FrostyTramy/RoboPacerV2/(commit log)

2026-08-01 Initial commit: RoboPacerV2
    RC car pacing project - Raspberry Pi 5 + Hailo-8 AI Kit.
    - data_recorder/: behavioral-cloning data capture (camera + Xbox controller)
    - camera/: standalone camera recorder
    - main/: autonomous drive - runs a .hef model on the Hailo, D-pad throttle control
    - trainer/: Windows-side training + Hailo HEF compile (Flask UI + Docker)
    - safety/: ESC fail-safe watchdog (systemd service)
    - tools/: servo and camera calibration utilities
    [camera_calibrate.py, data_recorder.py, main.py, servo_calibrate.py]
2026-08-01 Fix train/inference preprocessing docs, dataset loading robustness, trainer folder-or-json input
    - main.py: correct stale docstring (trainer now uses cv2, not PIL) and
    cross-reference train.py's preprocessing explicitly
    - trainer/train.py: SteeringDataset raises a clear error on an unreadable
    image instead of crashing on None; accept a dataset folder path (not
    just the driving_log.json file) and auto-append driving_log.json
    - trainer/index.html, README.md: reflect the folder-or-json input
    [main.py]
2026-08-01 Fail fast on missing Docker/DFC wheel, add compile-only recovery path
    The HEF compile step could fail after a multi-hour training run over a
    problem (Docker not running, DFC wheel not in place) that was entirely
    knowable before training started. Also fixed a bug where the .onnx
    export was deleted even when the compile step failed, making recovery
    impossible without retraining.
    - check_compile_prereqs(): checks Docker + the DFC wheel exist before
    training starts, not after
    - run(): only deletes .onnx/.har intermediates on a successful compile
    - retry_compile() + /api/compile + "Retry compile" button: recompiles
    from an existing .pth/.onnx without retraining; re-exports ONNX from
    the ch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
2026-08-01 Add 0-epoch pipeline smoke test, namespace calibration data per model
    - run_smoke_test() / "Test export (0 epochs)" button: builds an
    untrained model and runs it through the full ONNX export + Docker +
    Hailo DFC compile pipeline in seconds, so setup problems (wheel
    missing, Docker down, DFC bugs) surface before a multi-hour training
    run instead of after. Writes to models/smoketest.* only.
    - Fixed a real bug this introduced risk of: calib_data_nhwc.npy was a
    single shared file across all models/runs, so the smoke test (or any
    retry_compile of an older model) could silently overwrite a different
    model's calibration data. Now namespaced as <model_name>_calib_data_nhwc.npy
    in tra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
2026-08-01 Prevent CRLF-corrupted compile.sh, verify compile actually produced a .hef
    The smoke test caught a real bug: compile.sh got CRLF line endings on a
    Windows checkout (likely core.autocrlf), which breaks bash inside the
    Linux container in a way that's easy to miss - set -e itself gets
    mangled, so every subsequent hailo command fails but the script keeps
    going anyway and still prints "SUCCESS" at the end with exit code 0.
    - .gitattributes: force LF for *.sh/*.py/*.md/Dockerfile regardless of
    the checkout platform, CRLF for *.bat (native on Windows)
    - compile_hef(): stop trusting the script's exit code alone - verify
    models/<name>.hef actually exists on disk before reporting success
2026-08-01 Add ESC + controller drive test to servo_calibrate.py
    Static "wheels look straight" isn't the same as "goes straight while
    moving" - torque steer, alignment, and suspension slop only show up in
    motion. Now arms the ESC (if an Xbox controller is found) and reads
    gas/brake triggers the same way data_recorder.py does, so you can drive
    forward while live-adjusting the steering center trim with the keyboard.
    Falls back to servo-only calibration if no controller is connected.
    Rewrote the keyboard reader as non-blocking (select-based) so it can
    share the main loop with controller polling - the old version blocked
    on a single keypress, which doesn't work once there's a second input
    source to also w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
    [servo_calibrate.py]
2026-08-01 Add joystick steering to servo_calibrate.py
    Xbox left stick X now steers the servo, deflecting around whatever the
    keyboard-set trim pulse currently is - same deadzone shape as
    data_recorder.py's steering_axis_to_angle, just in raw microseconds
    around a live-adjustable center instead of a fixed angle. Lets you
    actually drive and steer normally while dialing in the center trim,
    instead of only being able to nudge a static pulse with the keyboard.
    [servo_calibrate.py]
2026-08-01 Add A-button TEST mode to servo_calibrate.py
    Press A to lock in the current min/center/max marks and drive steering
    through the exact angle math data_recorder.py/main.py use (deadzone,
    SERVO_OFFSET derived from the marks, angle->pulse via the calibrated
    min/max) instead of the generic symmetric trim range used while still
    adjusting. Press A again to go back to SET mode. Keyboard calibration
    keys are ignored while in TEST mode to avoid confusing live-adjustment
    with the committed snapshot being tested.
    [servo_calibrate.py]
2026-08-01 Make SET/TEST modes mutually exclusive in servo_calibrate.py
    SET mode: only the keyboard touches the servo, stick is fully ignored
    (not just deadzone - no effect at all). TEST mode: only the stick
    touches the servo, keyboard calibration keys do nothing. Previously the
    stick could also nudge the servo during SET mode, which wasn't the
    intent - SET should be keyboard-only until you explicitly switch to
    TEST with A. Removed the now-unused generic-trim-range steering
    function.
2026-08-01 Make TEST mode use exact marked min/center/max, not the safety-clamped angle range
    The previous TEST mode routed the stick through the same 45-135deg
    angle math the real system uses, which never reaches SERVO_MIN_PULSE/
    SERVO_MAX_PULSE exactly (that range is a deliberate safety margin below
    the physical endpoints) and introduced integer-degree rounding error at
    center. Replaced with a direct 3-point piecewise-linear mapping in
    pulse space: stick centered -> exactly the marked CENTER, full
    deflection either way -> exactly the marked MIN/MAX. This is for
    testing the calibration points themselves (does full lock-to-lock feel
    right), not for replicating production's clamped throw.
    [servo_calibrate.py]
2026-08-01 Add temporary debug logging for controller button events in servo_calibrate.py
    Investigating a report of TEST mode activating without pressing A and
    before all 3 marks are set - the guard logic requires both, so this
    prints every button press's raw evdev code to find out what's actually
    firing (possibly a different physical button reporting as BTN_A on this
    controller).
2026-08-01 Fix arrow keys getting silently dropped in servo_calibrate.py
    The escape-sequence continuation (ESC + 2 bytes for arrow keys) only
    waited 10ms and used a single read(2) call, which can short-read if the
    second byte hasn't arrived yet. Over SSH that's often not enough - the
    symptom was `pulse` staying frozen regardless of arrow presses.
    Read the 2 bytes one at a time with a 100ms timeout each instead.
    (Confirmed from a pasted session: every status line showed the exact
    same pulse=1500us, and min/max both got marked at that same default
    value - consistent with arrow presses never registering. The reported
    "auto-enters TEST mode" symptom didn't show up in that same session -
    no [debug] button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
    [servo_calibrate.py]
2026-08-01 Add raw keyboard byte debug logging to servo_calibrate.py
    Two reported sessions both show pulse/marks freezing entirely partway
    through - not just arrow keys, all keyboard input stops registering,
    including plain letters like 'c'. Logging every raw byte read from
    stdin and what key it resolved to, to find out whether bytes stop
    arriving entirely or arrive but get misparsed.
    [servo_calibrate.py]
2026-08-01 Remove debug logging from servo_calibrate.py
    Was just noise - false alarm turned out to be the debug prints
    themselves making it look like TEST mode had activated. Arrow-key fix
    and mutually-exclusive SET/TEST modes both confirmed working correctly.
    [servo_calibrate.py]
2026-08-01 Update servo calibration: min=900us, center=1580us, max=2200us
    SERVO_OFFSET recomputed from these marks: round((1580-900)/(2200-900)*180-90) = 4.
    Applied identically to data_recorder.py and main.py.
2026-08-01 Fix ESC arm pulse: use neutral, not full reverse/brake
    Root cause of the car occasionally launching into full-speed reverse
    right after (re)starting a script, confirmed against the QuicRun
    10BL120 manual: this ESC has no concept of a special "arm at an
    extreme pulse" signal - it just needs a stable, valid signal, and any
    pulse it receives is a real command it will act on. ESC_ARM_PULSE_US
    was set to 1000us (ESC_MIN_US, full reverse/brake), held for 3 seconds
    at every startup.
    In "Forward/Reverse with Brake" mode (this ESC's configured setting),
    holding brake/reverse position is only supposed to brake on the first
    push - reverse requires returning to neutral and pushing again. But
    depending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
    [data_recorder.py, main.py, servo_calibrate.py]
2026-08-02 Add steering deadzone/faster smoothing and frame-stacked temporal input
    - main.py: raise SMOOTH_ALPHA (less lag) and add STEERING_DEADZONE to cut
    the high-speed oscillation and straight-line weaving reported on track.
    - Add frame stacking (temporal memory): model now sees the current frame
    plus 2 history frames spaced ~100ms/~200ms apart in wall-clock time
    (not fixed frame-count stride, since consecutive captures at ~100fps
    are too close together to carry any motion signal). Implemented in
    train.py (dataset assembly, widened conv1 with tiled pretrained
    weights, calibration data) and main.py (live rolling buffer), with
    session-boundary-aware padding on both sides. Requires re-re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
    [data_recorder.py, main.py]
2026-08-02 Split train/val by time blocks, not individual frames
    Random per-frame shuffling let near-duplicate frames (a few ms apart at
    high recording fps) land on opposite sides of the split, letting val loss
    partly grade the model on frames it had effectively already trained on.
    Now shuffles and splits whole ~3s time blocks (cut at session boundaries)
    instead, so val actually measures generalization.
2026-08-02 Move frame writes off the control loop to fix multi-second freezes
    cv2.imwrite ran inline in the same loop that reads the controller and
    writes servo/ESC pulses. An SD card stall under sustained write load
    (garbage collection/wear-leveling) would block that single call for
    several seconds - freezing the entire loop with it, since nothing else
    runs until it returns. The PCA9685 holds its last duty cycle in hardware,
    so the car kept driving at whatever throttle/steering it had going into
    the stall, unresponsive to any input, looking like a stuck ESC/servo when
    it was actually just a frozen control loop. esc_watchdog didn't catch it
    either since the process was hung, not dead.
    Frame writes now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
    [data_recorder.py]
2026-08-02 Add --raw-steering flag to bypass smoothing/deadzone for testing
    Sends the model's unmodified per-frame prediction straight to the servo,
    so the model's actual raw output can be inspected separately from the
    EMA smoothing and deadzone tuning added on top of it.
2026-08-03 Add classic/timestamped recording formats and weighted steering sampling
    data_recorder.py gets a --legacy flag for classic (image + steering only)
    recording, alongside the default timestamped format needed for frame-stacked
    temporal input. train.py auto-detects which format a dataset is in and trains
    single-frame vs frame-stacked accordingly (model channels, export, calibration
    all follow); main.py auto-detects the same thing at inference time from the
    compiled HEF's own input shape, so nothing needs to be kept in sync manually.
    Also adds a WeightedRandomSampler over steering-magnitude buckets on the
    training split, since real driving logs are dominated by near-zero steering
    (74% exactly 0.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
2026-08-07 Add ESTOP/heartbeat safety daemon, controller rumble feedback, I2C fault tolerance
    - New safety/estop_listener.py + systemd service: reads !!ESTOP!! from an
    ESP32 over USB serial and kills running RoboPacerV2 processes (SIGTERM then
    SIGKILL), while also sending a !!HB!! heartbeat every 500ms so the ESP32's
    own watchdog can cut power if the Pi hangs or the link drops.
    - data_recorder.py: headless by default (--display to show the cv2 window),
    controller rumble on pause/resume/shutdown, servo+ESC stay responsive to
    the joystick while paused, tolerate transient I2C errors (121/19) instead
    of crashing, and don't fail cleanup if pca.deinit() hits a dead bus.
    - main.py: same I2C fault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
    [data_recorder.py, estop_listener.py, main.py]
2026-08-07 Add ESP32 firmware, estop listener and update gitignore
    - Esp32/garmin_receiver/garmin_receiver.ino: BLE GATT server with relay
    control, shared-secret auth, and serial watchdog (cuts relay if RPi
    heartbeat stops for 2s)
    - safety/estop_listener.py: RPi service that sends !!HB!! heartbeat to
    ESP32 and kills driving processes on !!ESTOP!! signal
    - .gitignore: exclude ConnectIQ app, frame sets, Pista-biciclete
2026-08-07 Move ESP32 BLE auth secret out of tracked source
    APP_SECRET was hardcoded in garmin_receiver.ino, which is on GitHub — move it
    to secrets.h (gitignored, lives next to the .ino, picked up automatically by
    Arduino IDE at compile time) and add secrets.h.example as the tracked
    template. The RPi side doesn't need this key at all; it's only shared
    between the Garmin watch app and the ESP32.
    [garmin_receiver.ino]
2026-08-07 Relay auto-on/off from RPi scripts and Garmin live status display
    ESP32:
    - Add STATUS_CHAR (READ) that holds relay state (0x00/0x01) for Garmin polling
    - Parse !!ON!! / !!OFF!! from serial to let RPi scripts control relay
    - Refactor relay writes into updateRelayState() so status char stays in sync
    RPi:
    - estop_listener: add Unix socket (/tmp/esp32_relay.sock) + relay queue;
    main serial loop drains queue and forwards ON/OFF to ESP32
    - main.py / data_recorder.py: send RELAY_ON on start, RELAY_OFF in finally
    Garmin:
    - RunningView: full green (ON) / red (OFF) background with large ON/OFF text
    - RunningDelegate: 1s timer polls STATUS_CHAR via requestRelayStatus()
    - BleManager: register STATUS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
2026-08-07 Add script launcher: start/stop Python scripts from Garmin watch
    - SCRIPTS_CHAR_UUID (READ) stores script list received from RPi via serial
    - CMD_RUN (0x10+idx): forwards !!RUN!!N to RPi; CMD_STOP (0x11): !!STOP!!
    - Parses !!SCRIPTS!!name:path|... from serial and updates characteristic
    - scripts.json: configurable list of launchable Python scripts
    - estop_listener: sends !!SCRIPTS!! to ESP32 after each serial connect
    - Handles !!RUN!!N (subprocess.Popen) and !!STOP!! (terminate managed proc)
    - Menu renamed: Running -> Releu, + new Files entry
    - FileListView/FileListDelegate: scrollable list of scripts from ESP32
    - FileRunView/FileRunDelegate: green/red background, UP=st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
2026-08-07 Add extensive debug logging for scripts BLE flow
2026-08-07 Ignore duplicate BLE commands on ESP32 (spam-with-confirmation pattern)
    - BTN_UP/BTN_DOWN ignored if relay already in desired state
    - CMD_RUN ignored if scriptLaunched flag set; CMD_STOP clears flag
    - scriptLaunched reset on disconnect and on !!OFF!! from RPi
    [garmin_receiver.ino]
2026-08-07 Rewrite ESP32 firmware and simplify RPi estop listener
    ESP32: stripped to relay ON/OFF only — dual output (LED GPIO2 +
    relay GPIO26), simplified BLE (WRITE + STATUS chars), watchdog
    unchanged, duplicate-state guard, sends !!ESTOP!! on relay OFF.
    estop_listener: removed scripts/socket/subprocess logic; now does
    exactly two things: heartbeat to ESP32 + kill processes on ESTOP.
2026-08-07 Remove dead relay-socket code from main.py/data_recorder.py
    estop_listener.py no longer opens /tmp/esp32_relay.sock (script
    launcher feature was dropped), so _relay_cmd() was a silent no-op.
    Also removes the now-unused safety/scripts.json.
    [data_recorder.py, main.py]
2026-08-07 Auto relay ON/OFF when Python scripts start/stop
    Re-adds Unix socket in estop_listener + !!ON!!/!!OFF!! serial
    commands to ESP32. main.py and data_recorder.py send RELAY_ON at
    start of try and RELAY_OFF in finally, routed through estop_listener
    which owns the serial port.
2026-08-08 Update pins for ESP32-CAM: RELAY_PIN 26->13, LED_PIN 2->4
    Claude-Session: https://claude.ai/code/session_01LXLjLP79To4mmYxGqTaX4B
2026-08-08 Add web dashboard for starting/stopping scripts with live console
    Flask app on port 8080 (systemd service, Restart=always, boot-enabled):
    Home page lists scripts.json entries plus live system stats (CPU/Hailo
    temp, relay state, ESP32/watchdog, controller). Run page has start/stop
    and a live console (SSE tailing a per-run log file, so any client - new
    or reconnected - always sees the full run history, not just new lines).
    Only one script can run at a time (server-side mutex); starting a second
    one while another runs returns 409 with what's running, and the frontend
    offers to stop it first. Stop sends SIGTERM, which is enough to trigger
    the existing relay-off in main.py/data_recorder.py's own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
2026-08-08 Keep relay state on BLE disconnect — watchdog controls it
    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
2026-08-11 Add odometry: ESP32 sends RPM, RPi calculates km/h and pace
2026-08-11 Add odometry display tool and RPM socket broadcast
2026-08-11 Add start-time flags UI, unbuffered live console, and serial DTR/RTS fix
    Dashboard: run page now shows checkboxes for each script's whitelisted
    CLI flags (from scripts.json), validated server-side before exec; console
    clears and reconnects on every Start instead of tailing stale output;
    scripts run with `python3 -u` so log lines appear live instead of only
    after the process exits (stdout was fully buffered when piped to a file).
    estop_listener: open the serial port with DTR/RTS held low before connecting,
    otherwise the ESP32 (CH340 auto-reset circuit) stays stuck in the bootloader
    and never boots into firmware.
    Claude-Session: https:/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
    [estop_listener.py]
2026-08-11 Add manual_drive.py: pure controller-drive script, no recording
    Same A/Y/B layout as data_recorder.py, but pause (Y) actually cuts the
    servo/motor and ignores stick input entirely until resume (A) - in
    data_recorder pause only stopped frame recording, driving continued.
    B stops the script; SIGTERM/estop path reuses the same relay-off +
    neutral-ESC cleanup as main.py/data_recorder.py, and the script lives
    under PROJECT_DIR so estop_listener's kill_target_processes() catches
    it like the others. Registered in dashboard/scripts.json (no flags).
    Claude-Session: https://claude.ai/code/session_014fzAiTbTMo4vmSnn1Lyk4d
2026-08-11 Log speed (rpm/km-h/pace) every 0.5s in manual_drive.py, new file per run
    Reads RPM off estop_listener's odometry socket on a background thread
    (same protocol as tools/odometry.py) so a stalled/missing connection
    never blocks the control loop - falls back to 0 until it reconnects.
    Every 0.5s appends a CSV row (elapsed_s,rpm,kmh,pace_mmss) to a fresh
    speed_<timestamp>.csv under manual_drive/speed_logs/ (gitignored, like
    the other captured-data folders), and writes an avg/max summary for
    all three units as the last lines on shutdown - including on early
    failures (e.g. controller not found), since run_start_time is bound
    before anything that can raise.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
    [manual_drive.py]
2026-08-11 Cache Hailo temp reads and close SSE streams on hidden tabs
    get_hailo_temp() opened a fresh hailo_platform.VDevice() on every poll
    (every 2s per open tab), and HailoRT leaks native OS threads on each
    open that never get released - this was the dashboard's progressive
    lag. Cache the reading for 30s so hardware is polled far less often,
    and close/reopen both EventSource streams on visibilitychange so
    backgrounded tabs stop holding connections against the browser's
    6-per-origin limit.
2026-08-11 Send ESC neutral signal before applying relay power, log distance
    ESCs expect a valid PWM signal from the moment they receive power;
    previously the relay was switched on first and PCA9685/ESC setup
    happened afterward, leaving the ESC powered with no signal for a
    couple seconds - many ESCs treat that as a failsafe condition and
    refuse to arm. Now PCA9685/ESC/servo are configured and driven to
    neutral before RELAY_ON fires.
    manual_drive.py also now integrates speed into a running distance
    (km/h -> m/s times elapsed tick) and reports it in the end-of-run
    summary alongside the existing RPM/km-h/pace stats.
    [data_recorder.py, main.py, manual_drive.py]
2026-08-11 Exclude dashboard from the ESTOP process kill
    kill_target_processes() matched any Python process under PROJECT_DIR,
    which included dashboard/app.py even though it never touches the
    motor/servo directly - it only launches other scripts and reports
    status. Every relay-off (including ones triggered externally via the
    watch's BLE connection, unrelated to any running driving script) was
    killing and restarting the dashboard. Confirmed via a live PCA9685
    register trace that this restart churn could race a dying process
    against a freshly (re)started one on the same I2C channel during the
    exact window a script was trying to arm the ESC.
2026-08-11 Add manual_drive.py to esc_watchdog.sh's allowed-script list
    esc-watchdog.service polls every 0.3s and force-writes the PCA9685 ESC
    channel to hard full-off whenever none of ALLOWED_SCRIPTS is running,
    as a fail-safe against a crashed/killed script leaving a stale duty
    cycle live. manual_drive.py was never added when it was created this
    session, so the watchdog treated it as "nothing allowed running" the
    entire time it ran and clobbered every arm/neutral pulse within
    ~300ms - independent of anything in manual_drive.py's own code, which
    is why swapping its contents for data_recorder.py's didn't change the
    outcome (the watchdog matches by process path via pgrep -f, not code
    content).
2026-08-13 Merge model steering + cruise control into a new autopilot main.py
    - Rename the old model-only script to model_runner/model_runner.py;
    main/main.py is now model steering + cruise-control speed-hold +
    distance auto-stop, with dense 50Hz CSV logging and a dedicated
    dashboard page (speed/pace + distance form, live telemetry,
    collapsible console). Both scripts registered in esc_watchdog.sh's
    allowlist; trainer docs updated to reflect the split.
    - Add cruise_control/cruise_control.py (feedforward+PI speed regulator,
    10s pace-recovery loop, 100m split logging, ESC-saturation notes) and
    its dashboard integration, plus tools/plot_cruise_log.py for its logs.
    - Add manual_drive.py live t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
2026-08-13 Add triple-switch trainer UI with PTH-only and compile-from-PTH modes
    - Triple switch (green/blue/orange) replaces old toggle: full train / PTH only / compile from PTH
    - PTH-only mode (RunPod): trains and saves .pth, skips ONNX/HEF — flag pth_only in train.py
    - Compile-from-PTH mode: loads .pth, exports ONNX, compiles HEF with optional calib .npy
    - Native file browser via tkinter dialogs served through Flask /api/browse endpoints
    - smoketest_pth: validates Docker+Hailo compile without a dataset
2026-08-15 Fix Hall sensor thresholds and detection polarity for KY-024
    Sensor reads high (~2700+) when magnet present, low (<2000) when absent.
    Updated MAG_THRESHOLD_ON/OFF and flipped comparisons from < to >.
    Removed live MAG: debug print.
    [garmin_receiver.ino]
2026-09-20 Add dataset picker to data recorder, shared camera_config, raw steering for main
    - data_recorder: --dataset NAME / --new-dataset select the output folder
    (continues from the folder's last frame); folder is created lazily.
    - dashboard: Data Recorder page lists folders that already have frames plus
    "Folder nou"; /api/data_recorder/datasets and validated dataset args on start.
    - camera_config.py: single source of truth for camera setup, used by
    camera, data_recorder, main, model_runner and camera_calibrate.
    - main: raw steering by default, --smooth-steering opt-in (checkbox on the
    dashboard page).
2026-09-20 Add RAM frame cache, torch.compile, bigger batch/workers for --a100
    Disk I/O was the real bottleneck (GPU sat at 0-4% util while CPU wasn't
    even saturated) because frame-stacking + WeightedRandomSampler re-read
    the same images from disk repeatedly. Preloading every unique frame into
    RAM once (threaded decode, shared across DataLoader workers via fork
    copy-on-write) removes that entirely. Also bumps num_workers 4->12,
    batch size 128->512, and adds torch.compile - all still gated behind
    --a100 so Windows/web-UI training is untouched.
2026-09-20 Fix train_loss denominator mismatch with drop_last
    _train_epoch tracked the correct sample count in `samples` (used
    correctly for the mid-epoch progress logs) but divided the final
    returned train_loss by len(loader.dataset) instead - harmless before,
    but with --a100's new drop_last=True this silently drops the last
    partial batch each epoch, so the two counts diverge and the returned
    train_loss was a slightly wrong (deflated) average. Divide by `samples`
    throughout, which is correct with or without drop_last.
2026-09-20 Add real-calibration-data helper for compile-from-pth, ignore PistaAtletism dataset
    Generates a real (non-synthetic) Hailo calibration .npy from a local dataset
    so the "Compile from PTH" flow doesn't fall back to random calibration data.
2026-09-24 Rewrite trainer subsystem: split train.py into train_core.py + compile_pipeline.py
    Separates the two real workflows (Windows web UI vs RunPod/A100 headless
    training) into clean entry points, adds Standard/Custom UI toggle, real
    calibration data by default instead of synthetic fallback, and an
    INSTALL.md/RUNPOD_WORKFLOW.md tutorial. Training recipe itself is
    unchanged - only how it's packaged and exposed.
