FrostyTramy/RoboPacerV2/(notices)

Notices in the files:
README.md:
License: MIT
