FrostyTramy/RoboPacerV2/docs/images/robot2.jpg

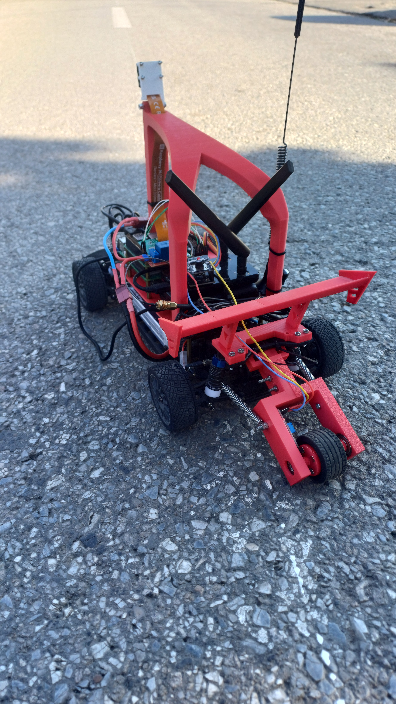
[picture p2: docs/images/robot2.jpg]
docs/images/robot2.jpg
