FrostyTramy/RoboPacerV2/docs/images/robot3.jpg

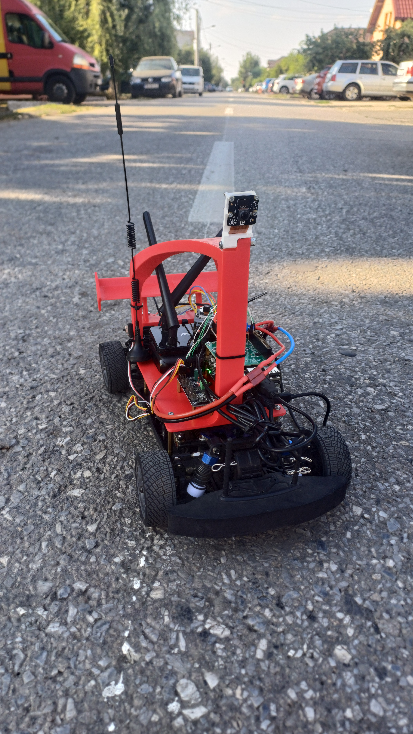
[picture p3: docs/images/robot3.jpg]
docs/images/robot3.jpg
